ch98-1/High-Voltage-Power-Supply/README.md

# High Voltage Power Supply
High voltage power supply for main capacitor and igniter for PPT systems
