ch98-1/High-Voltage-Power-Supply/Enclosure/HVPS_Enclosure.FCStd

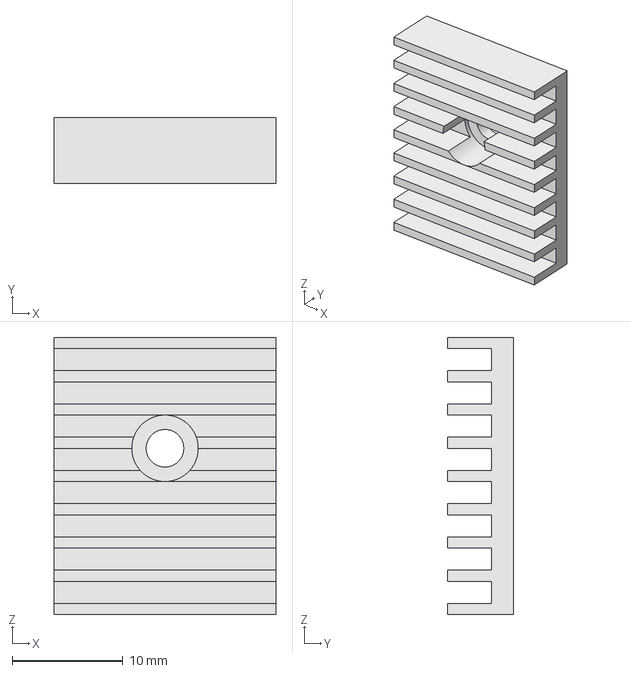
[picture p1: CAD file, 2021-12-09]
Enclosure/HVPS_Enclosure.FCStd
20.0 x 6.00 x 25.0 mm
