ch98-1/High-Voltage-Power-Supply/(list of files, cad)

Other CAD files:
Enclosure/HVPS_Enclosure-Heatsink.step
