ch98-1/High-Voltage-Power-Supply/High_Voltage_Power_Supply/High_Voltage_Power_Supply.pdf

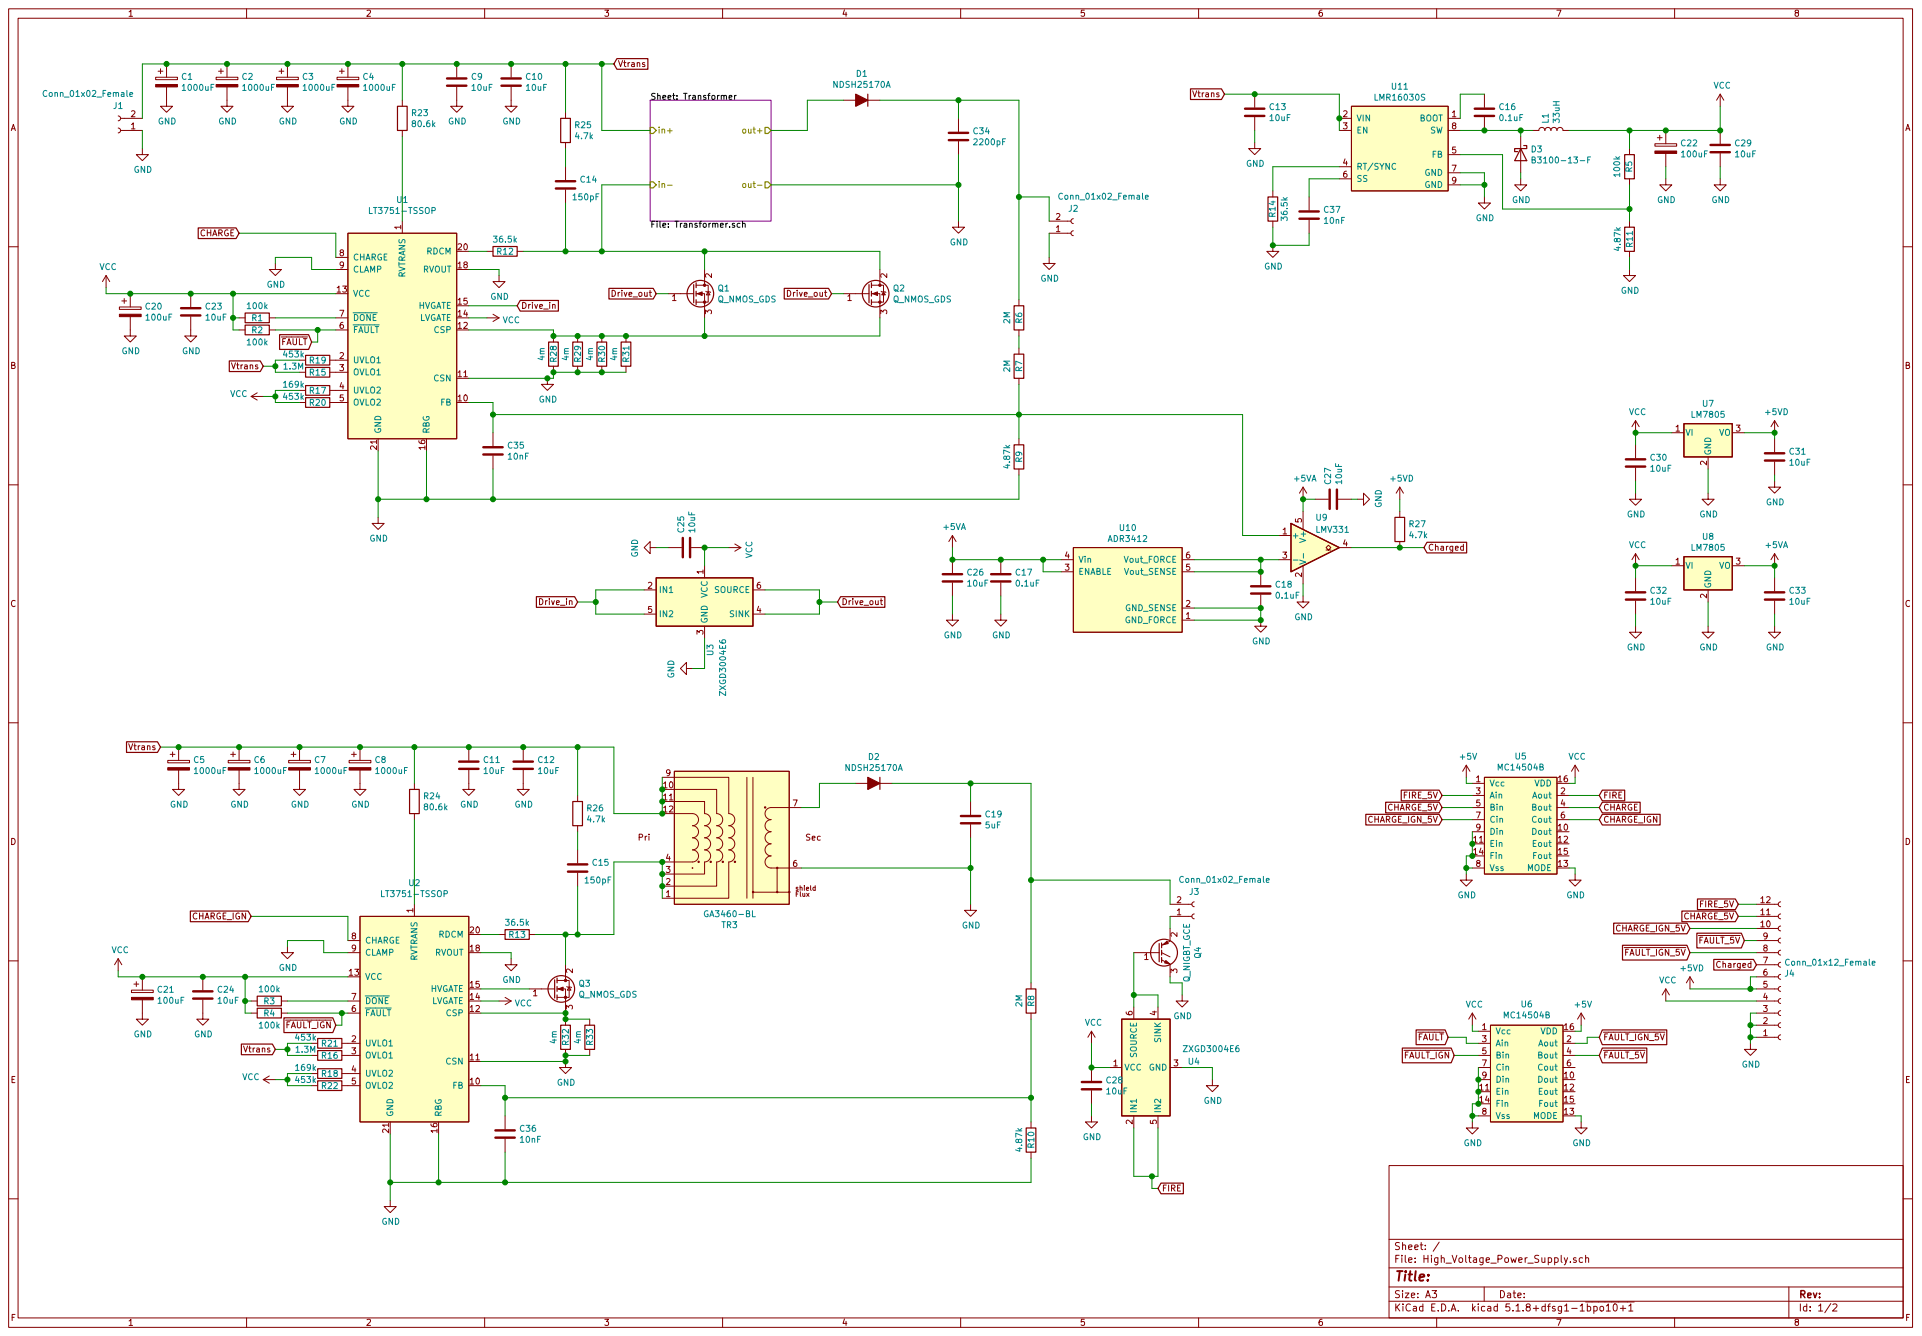
[picture p2: page 1]

Sheet: Transformer File: Transformer.sch

1 FB 10 CSN 11 CSP 12 VCC 13

11
12

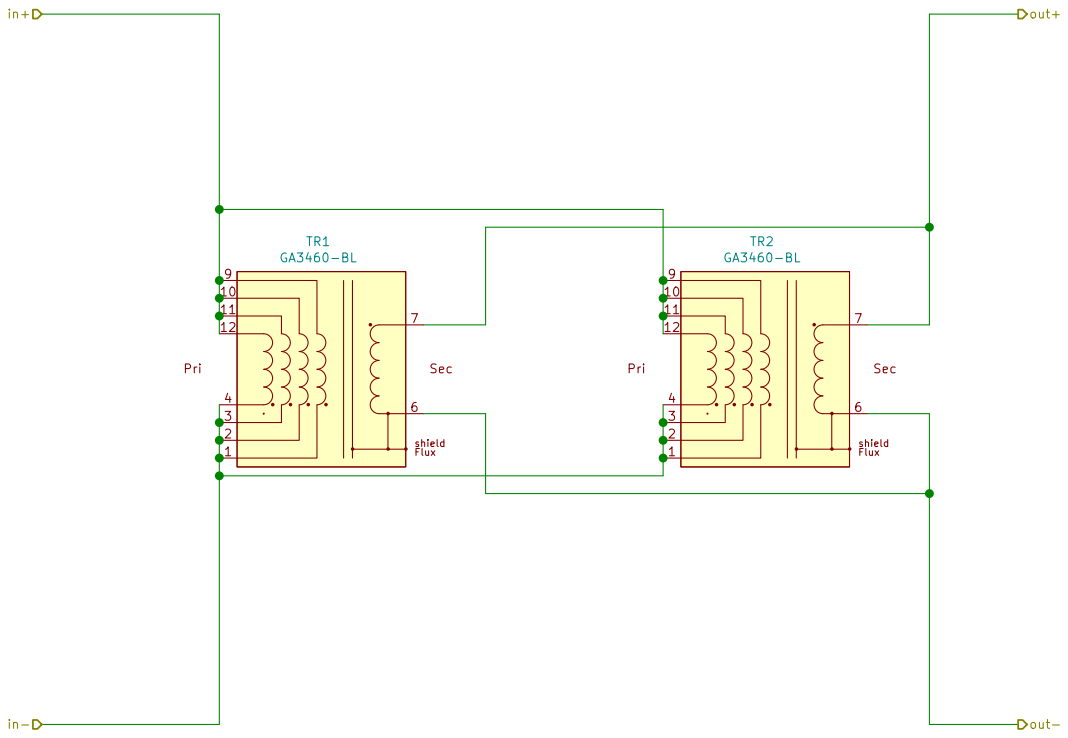
[picture p3: page 2]

Id: 2/2 Title: File: Transformer.sch Sheet: /Transformer/
