ch98-1/High-Voltage-Power-Supply/LTspice_Simulation/High_Voltage_Power_Supply_Simulation.asc

C1: cap; 2200pf
C2: cap; 80µf
C3: cap; 10nF
D1: diode; DNDSH25170A
L1: ind2; 1.125µH; Rser=2.815m
L2: ind2; 112.5µH; Rser=200m
M1: nmos; IXFK180N25T
M2: nmos; IPB200N25N3
R1: res; 80.6k
R2: res; 2Meg
R3: res; 2Meg
R4: res; 4.87k
R6: res; 1m
R7: res; 36.5k
R9: res; 100k
R10: res; 100k
R11: res; 1.3Meg
R12: res; 453k
R13: res; 453k
R14: res; 169k
U1: LT3751
V1: voltage; 12; Rser=0
V2: voltage; 48; Rser=0
V3: voltage; PULSE(0 12 1m 100n 100n 100)
Named nets: 0, VCC, vout, vtrans
K1 L1 L2 1
.tran 10ns 100m uic
.model IXFK180N25T NMOS(Vds=250 Ron=12.9m Qg=345n)
.model DNDSH25170A D (RS=0 BV=1700 IBV=50u )
