ch98-1/High-Voltage-Power-Supply/High_Voltage_Power_Supply/High_Voltage_Power_Supply.kicad_pcb

## KiCad design High_Voltage_Power_Supply/High_Voltage_Power_Supply.kicad_pcb (2021-12-11)

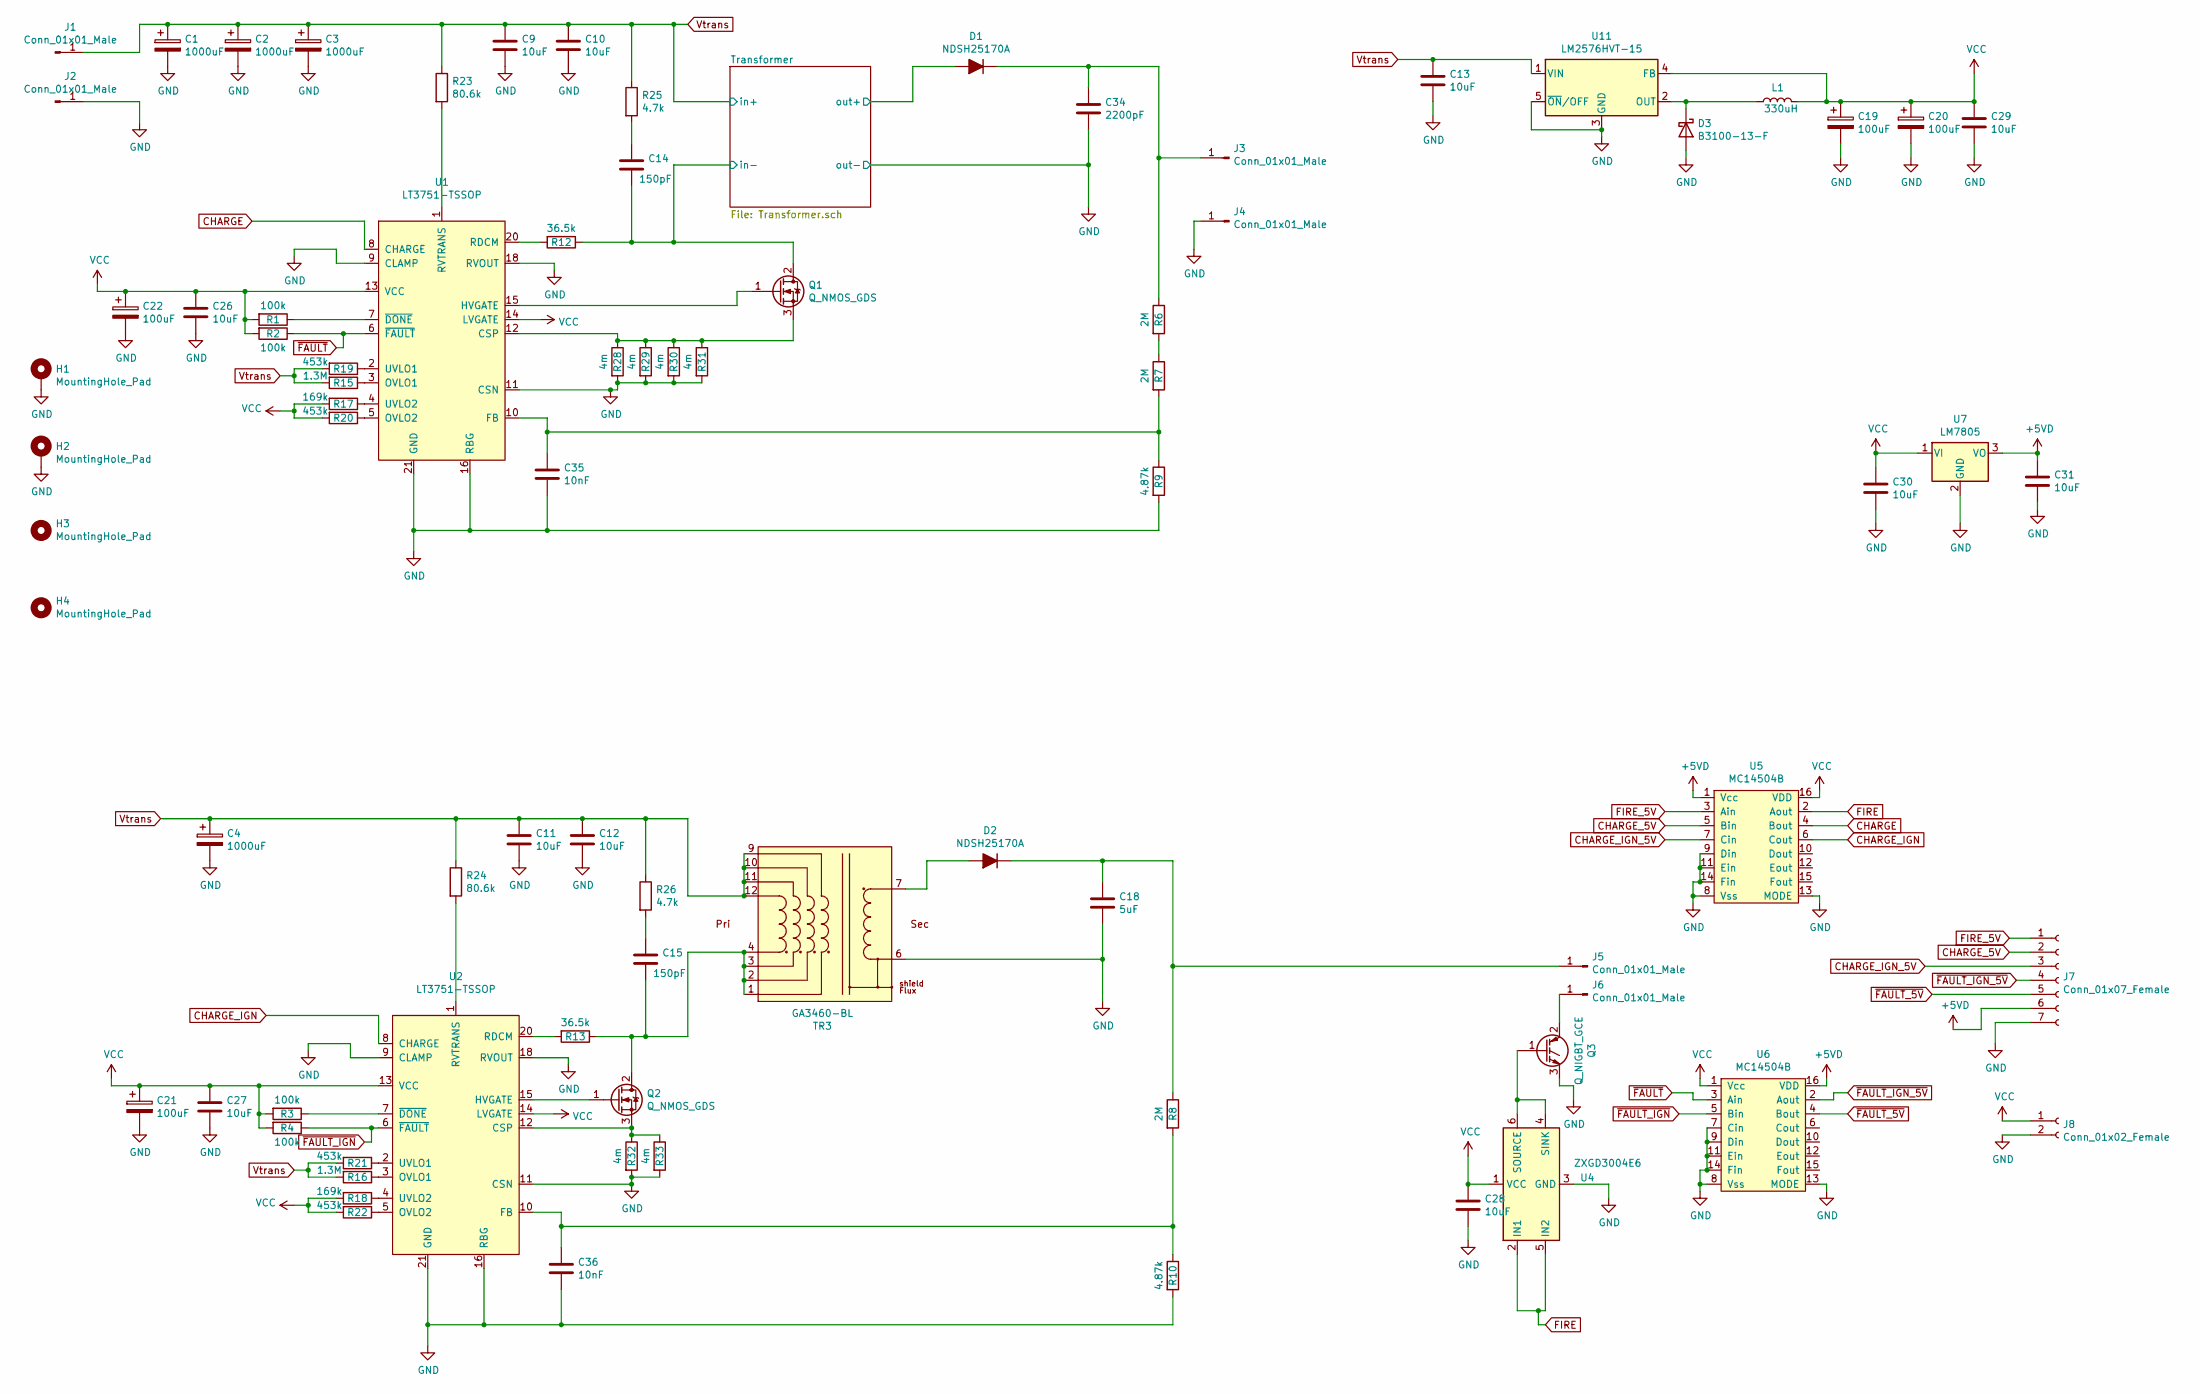
[picture p4: schematic High_Voltage_Power_Supply.sch]

Parts:
C1, C2, C3, C4: 1000uF; CP_Radial_D18.0mm_P7.50mm
C9, C10, C11, C12, C13: 10uF; C_1210_3225Metric; Voltage >100V
C14, C15: 150pF; C_1206_3216Metric
C18: 5uF; C_Rect_L31.5mm_W20.0mm_P27.50mm_MKS4; Voltage >600V
C19, C20, C21, C22: 100uF; CP_Radial_D8.0mm_P5.00mm
C26, C27, C28, C29, C30, C31: 10uF; C_1206_3216Metric; Voltage >50V
C34: 2200pF; C_1812_4532Metric; Voltage >1200V
C35, C36: 10nF; C_0603_1608Metric
D1, D2: NDSH25170A; TO-247-2_Vertical
D3: B3100-13-F; D_SMC
H1, H2: MountingHole_Pad; MountingHole_3.2mm_M3_Pad_Via
H3, H4: MountingHole_Pad; MountingHole_3.2mm_M3
J1, J2, J3, J4, J5, J6: Conn_01x01_Male; Banana_Jack_1Pin
J7: Conn_01x07_Female; PinHeader_1x07_P2.54mm_Vertical
J8: Conn_01x02_Female; PinHeader_1x02_P2.54mm_Vertical
L1: 330uH; 60B334C
Q1, Q2: Q_NMOS_GDS; TO-264-3_Vertical; Voltage 200V
Q3: Q_NIGBT_GCE; TO-247-3_Vertical; Voltage >600V
R1, R2, R3, R4: 100k; R_0603_1608Metric
R6, R7, R8: 2M; R_1206_3216Metric
R9, R10: 4.87k; R_1206_3216Metric
R12, R13: 36.5k; R_0603_1608Metric
R15, R16: 1.3M; R_0805_2012Metric
R17, R18: 169k; R_0805_2012Metric
R19, R20, R21, R22: 453k; R_0805_2012Metric
R23, R24: 80.6k; R_0603_1608Metric
R25, R26: 4.7k; R_1206_3216Metric
R28, R29, R30, R31, R32, R33: 4m; R_2512_6332Metric
TR3: GA3460-BL; Transformer_Coilcraft_GA3460-BL
U1, U2: LT3751-TSSOP; HTSSOP-20-1EP_4.4x6.5mm_P0.65mm_EP3.4x6.5mm_ThermalVias
U4: ZXGD3004E6; SOT-23-6
U5, U6: MC14504B; SOIC-16_3.9x9.9mm_P1.27mm
U7: LM7805; SOT-223-3_TabPin2
U11: LM2576HVT-15; TO-220-5_Vertical

Connections:
+5VD: C31.1, J7.6, U5.1 (Vcc), U6.16 (VDD), U7.3 (VO)
/Transformer/in-: C14.2, Q1.2 (D), R12.1; also elsewhere on the board
/Transformer/out+: D1.2 (A); also elsewhere on the board
CHARGE: U1.8 (CHARGE), U5.4 (Bout)
CHARGE_5V: J7.2, U5.5 (Bin)
CHARGE_IGN: U2.8 (CHARGE), U5.6 (Cout)
CHARGE_IGN_5V: J7.3, U5.7 (Cin)
FIRE: U4.2 (IN1), U4.5 (IN2), U5.2 (Aout)
FIRE_5V: J7.1, U5.3 (Ain)
GND: C1.2, C2.2, C3.2, C4.2, C9.2, C10.2, C11.2, C12.2, C13.2, C18.2, C19.2, C20.2, C21.2, C22.2, C26.2, C27.2, C28.2, C29.2, C30.2, C31.2, C34.2, C35.2, C36.2, D3.2 (A), H1.1, H2.1, J2.1, J4.1, J7.7, J8.2, Q3.3 (E), R9.2, R10.2, R28.2, R29.2, R30.2, R31.2, R32.2, R33.2, TR3.6, U1.9 (CLAMP), U1.11 (CSN), U1.16 (RBG), U1.18 (RVOUT), U1.21 (GND), U2.9 (CLAMP), U2.11 (CSN), U2.16 (RBG), U2.18 (RVOUT), U2.21 (GND), U4.3 (GND), U5.8 (Vss), U5.9 (Din), U5.11 (Ein), U5.13 (MODE), U5.14 (Fin), U6.7 (Cin), U6.8 (Vss), U6.9 (Din), U6.11 (Ein), U6.13 (MODE), U6.14 (Fin), U7.2 (GND), U11.3 (GND), U11.5 (~ON~/OFF); also elsewhere on the board
unnamed: C14.1, R25.2
unnamed: C15.1, R26.2
unnamed: C15.2, Q2.2 (D), R13.1, TR3.1, TR3.2, TR3.3, TR3.4
unnamed: C18.1, D2.1 (K), J5.1, R8.1
unnamed: C34.1, D1.1 (K), J3.1, R6.1
unnamed: C35.1, R7.2, R9.1, U1.10 (FB)
unnamed: C36.1, R8.2, R10.1, U2.10 (FB)
unnamed: D2.2 (A), TR3.7
unnamed: D3.1 (K), L1.1, U11.2 (OUT)
unnamed: J6.1, Q3.2 (C)
unnamed: Q1.1 (G), U1.15 (HVGATE)
unnamed: Q1.3 (S), R28.1, R29.1, R30.1, R31.1, U1.12 (CSP)
unnamed: Q2.1 (G), U2.15 (HVGATE)
unnamed: Q2.3 (S), R32.1, R33.1, U2.12 (CSP)
unnamed: Q3.1 (G), U4.4 (SINK), U4.6 (SOURCE)
unnamed: R1.1, U1.7 (~DONE~)
unnamed: R3.1, U2.7 (~DONE~)
unnamed: R6.2, R7.1
unnamed: R12.2, U1.20 (RDCM)
unnamed: R13.2, U2.20 (RDCM)
unnamed: R15.1, U1.3 (OVLO1)
unnamed: R16.1, U2.3 (OVLO1)
unnamed: R17.1, U1.4 (UVLO2)
unnamed: R18.1, U2.4 (UVLO2)
unnamed: R19.1, U1.2 (UVLO1)
unnamed: R20.1, U1.5 (OVLO2)
unnamed: R21.1, U2.2 (UVLO1)
unnamed: R22.1, U2.5 (OVLO2)
unnamed: R23.2, U1.1 (RVTRANS)
unnamed: R24.2, U2.1 (RVTRANS)
VCC: C19.1, C20.1, C21.1, C22.1, C26.1, C27.1, C28.1, C29.1, C30.1, J8.1, L1.2, R1.2, R2.2, R3.2, R4.2, R17.2, R18.2, R20.2, R22.2, U1.13 (VCC), U1.14 (LVGATE), U2.13 (VCC), U2.14 (LVGATE), U4.1 (VCC), U5.16 (VDD), U6.1 (Vcc), U7.1 (VI), U11.4 (FB)
Vtrans: C1.1, C2.1, C3.1, C4.1, C9.1, C10.1, C11.1, C12.1, C13.1, J1.1, R15.2, R16.2, R19.2, R21.2, R23.1, R24.1, R25.1, R26.1, TR3.9, TR3.10, TR3.11, TR3.12, U11.1 (VIN); also elsewhere on the board
~FAULT_5V~: J7.5, U6.4 (Bout)
~FAULT_IGN_5V~: J7.4, U6.2 (Aout)
~FAULT_IGN~: R4.1, U2.6 (~FAULT~), U6.5 (Bin)
~FAULT~: R2.1, U1.6 (~FAULT~), U6.3 (Ain)

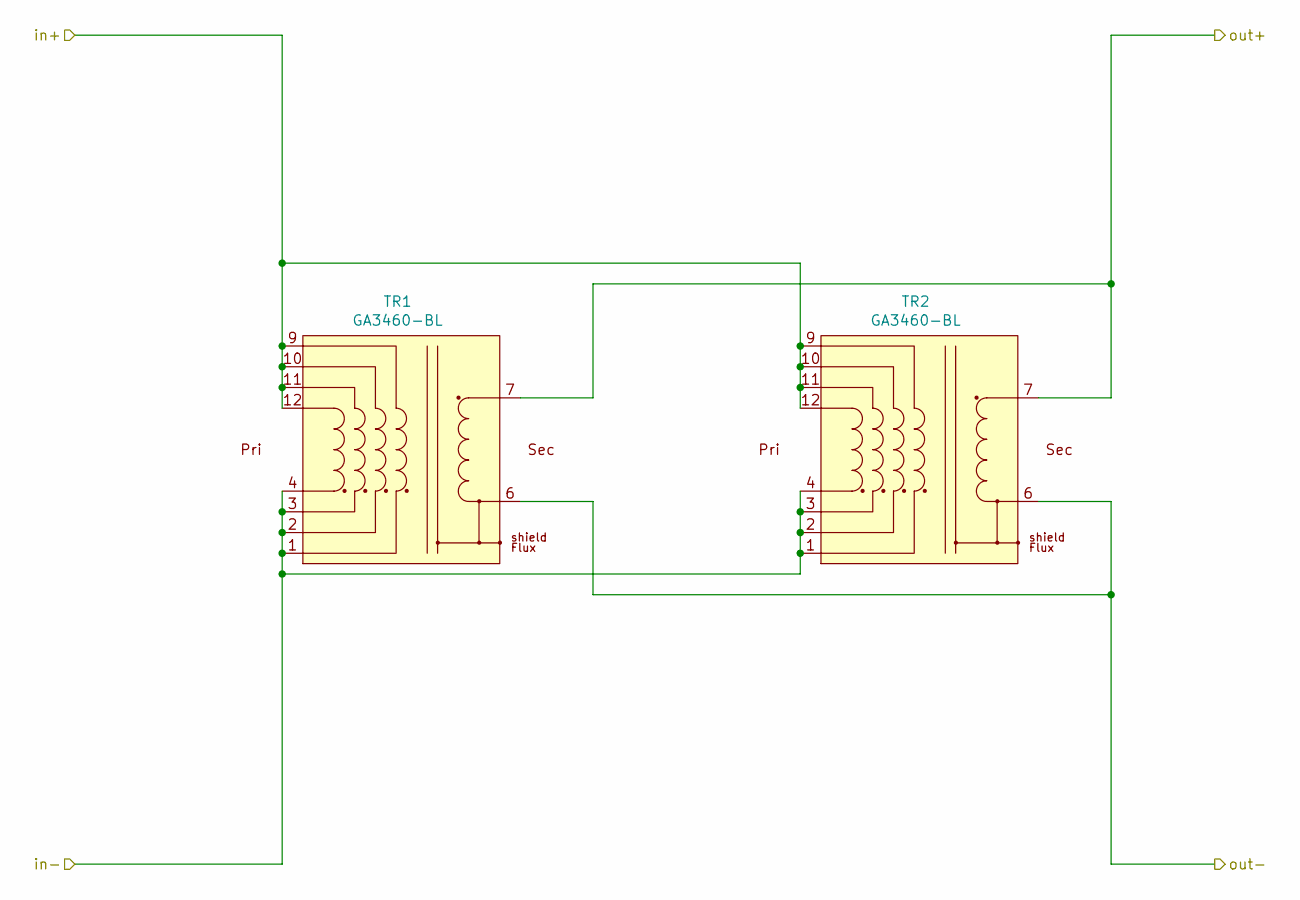
[picture p5: schematic Transformer.sch]

Parts:
TR1, TR2: GA3460-BL; Transformer_Coilcraft_GA3460-BL

Connections:
/Transformer/in-: TR1.1, TR1.2, TR1.3, TR1.4, TR2.1, TR2.2, TR2.3, TR2.4; also elsewhere on the board
/Transformer/out+: TR1.7, TR2.7; also elsewhere on the board
GND: TR1.6, TR2.6; also elsewhere on the board
Vtrans: TR1.9, TR1.10, TR1.11, TR1.12, TR2.9, TR2.10, TR2.11, TR2.12; also elsewhere on the board

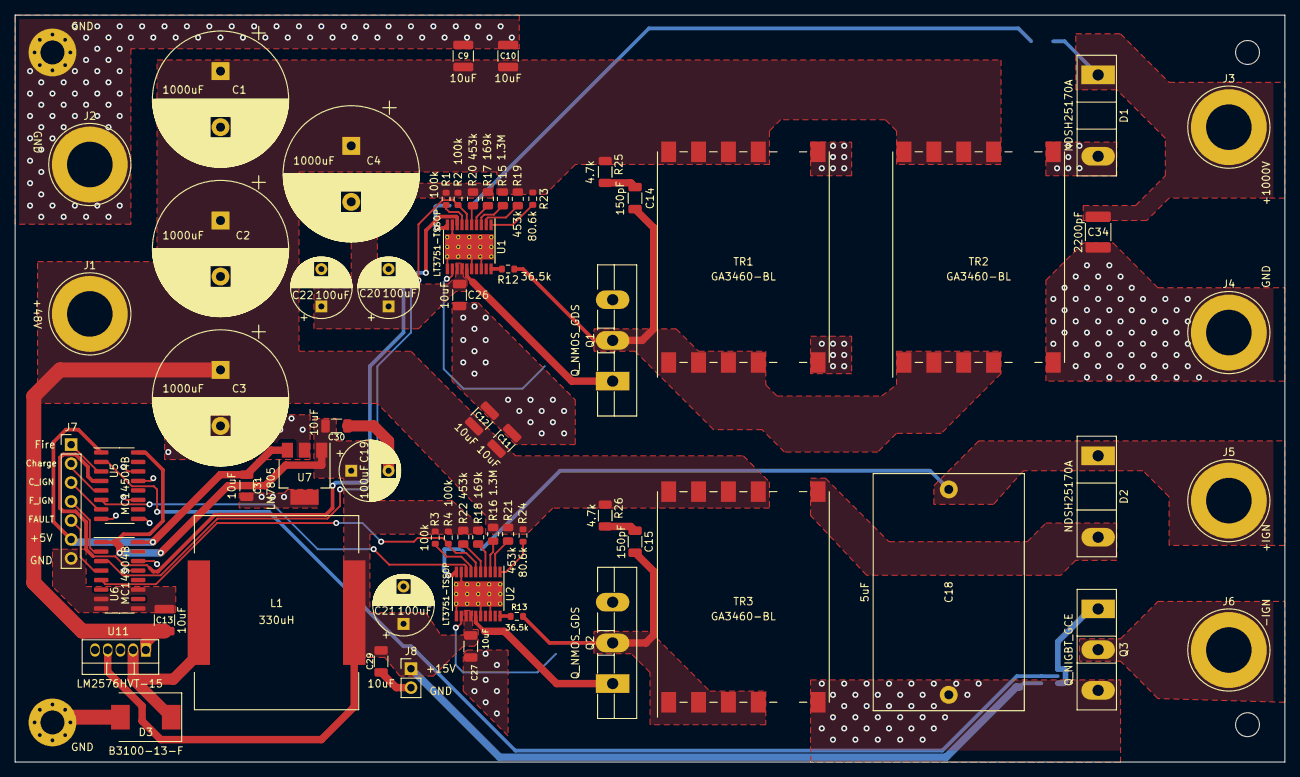
[picture p6: board High_Voltage_Power_Supply.kicad_pcb from above]

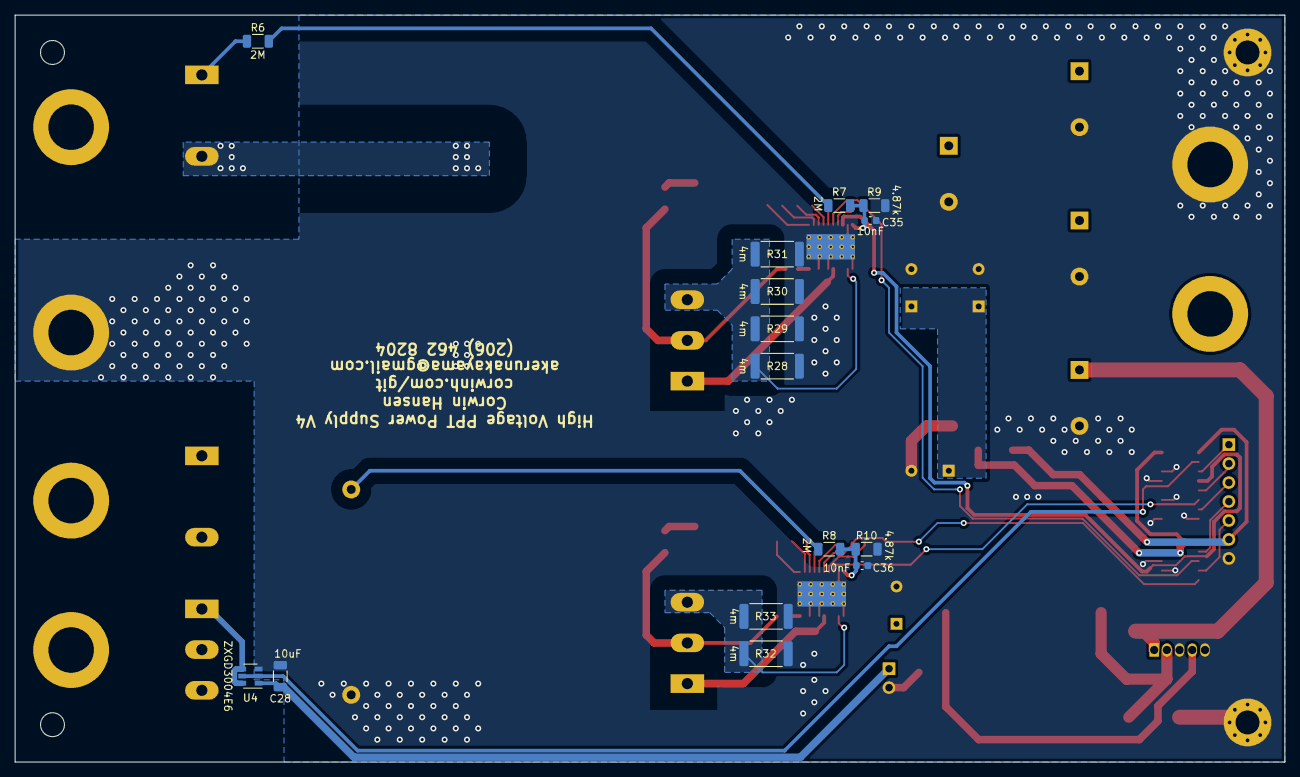
[picture p7: board High_Voltage_Power_Supply.kicad_pcb from below]

Board: 2 copper layers, 170.0 x 100.0 mm, 83 parts (15 on the bottom side), 46 nets.
