ch98-1/High-Voltage-Power-Supply/(commit log)

2018-08-30 Added project files and license
    [High Voltage Power Supply.kicad_pcb, High Voltage Power Supply.sch]
2018-08-31 Finished basic power supply schematic
    [High Voltage Power Supply.sch, High_Voltage_Power_Supply.kicad_pcb, High_Voltage_Power_Supply.sch]
2018-08-31 Centered schematic
    [High_Voltage_Power_Supply.sch]
2019-02-21 Added schimatic PDF
    [High_Voltage_Power_Supply.sch]
2020-08-05 More basic component updates
    [Transformer.sch]
2020-08-08 Finalised the schematic and BOM
    [Bom_Digikey.csv, High_Voltage_Power_Supply.sch, Transformer.sch]
2020-08-08 Started on the PCB
    [High_Voltage_Power_Supply.sch]
2020-08-14 Finished most of the PCB layout
    [High_Voltage_Power_Supply.kicad_pcb, High_Voltage_Power_Supply.sch, Transformer.sch]
2020-08-14 Added Done and Fault outputs
    [High_Voltage_Power_Supply.kicad_pcb, High_Voltage_Power_Supply.sch]
2020-08-15 Updated text location
    [High_Voltage_Power_Supply.kicad_pcb]
2020-08-19 Started on LTspice simulation file for the circuit
2020-08-21 minor pcb update
    [High_Voltage_Power_Supply.kicad_pcb]
2020-08-21 updated pcb
2020-08-26 Added some notes for it
    [High_Voltage_Power_Supply.sch]
2020-08-26 Fixed the order qualtity mistake
    [Bom_Digikey.csv]
2020-09-05 modified PCB to have all the silkscreen text visible
    [High_Voltage_Power_Supply.kicad_pcb]
2020-09-05 Removed a via in the wrong position
    [High_Voltage_Power_Supply.kicad_pcb]
2020-10-01 Updated schematic to run on regulation mode only
    [Bom_Digikey.csv, High_Voltage_Power_Supply.kicad_pcb, High_Voltage_Power_Supply.sch, Transformer.sch]
2020-10-01 Started PCB layout for new version of the board
    [High_Voltage_Power_Supply.kicad_pcb]
2020-10-02 removed unnecessory item from bom
    [Bom_Digikey.csv]
2020-10-03 did more pcb layout
    [High_Voltage_Power_Supply.kicad_pcb]
2020-10-03 filled unfilled zones
    [High_Voltage_Power_Supply.kicad_pcb]
2020-10-15 Started design of the ignitor circuit
    [High_Voltage_Power_Supply.kicad_pcb, High_Voltage_Power_Supply.sch, Transformer.sch]
2020-10-18 schematic update
    [High_Voltage_Power_Supply.sch]
2020-10-28 Finished the v2 of the schematic
    [High_Voltage_Power_Supply.sch, Transformer.sch]
2020-10-28 Updated BOM
    [Bom_Digikey.csv, High_Voltage_Power_Supply.sch]
2020-10-29 pcb fully layed out
    [Bom_Digikey.csv, High_Voltage_Power_Supply.kicad_pcb, High_Voltage_Power_Supply.sch]
2020-10-29 Layout update for minor labling issues
    [High_Voltage_Power_Supply.kicad_pcb]
2020-10-29 more layout update
    [High_Voltage_Power_Supply.kicad_pcb]
2020-10-29 added labels on pins
    [High_Voltage_Power_Supply.kicad_pcb]
2020-11-12 made small adjustments to pcb to clean it up a bit
    [High_Voltage_Power_Supply.kicad_pcb]
2020-11-12 more change with vias
    [High_Voltage_Power_Supply.kicad_pcb]
2020-11-14 updated text to be right way around
    [High_Voltage_Power_Supply.kicad_pcb]
2020-11-17 pin labling error fixed and arduino project for testing added
    [High_Voltage_Power_Supply.kicad_pcb]
2021-04-23 Created V3 of the schematic
    [High_Voltage_Power_Supply.kicad_pcb, High_Voltage_Power_Supply.sch]
2021-04-27 schematic update with mounting holes
    [High_Voltage_Power_Supply.kicad_pcb, High_Voltage_Power_Supply.sch]
2021-05-25 added new components and replaced out of stock ones in BOM
    [Bom_Digikey.csv, High_Voltage_Power_Supply.kicad_pcb, High_Voltage_Power_Supply.sch]
2021-05-27 Edited schematic to use new buck converter chip.
    [Bom_Digikey.csv, High_Voltage_Power_Supply.kicad_pcb, High_Voltage_Power_Supply.sch]
2021-06-15 Rough component placements to allow heat sinks to be installed
    [High_Voltage_Power_Supply.kicad_pcb, High_Voltage_Power_Supply.sch]
2021-06-19 routed most of the components on pcb
    [High_Voltage_Power_Supply.kicad_pcb, High_Voltage_Power_Supply.sch]
2021-06-19 more work on pcb routuing
    [High_Voltage_Power_Supply.kicad_pcb]
2021-06-22 traces fully laid out
    [High_Voltage_Power_Supply.kicad_pcb]
2021-06-22 labeled components
    [High_Voltage_Power_Supply.kicad_pcb]
2021-06-22 updated silkscreen labeling
    [High_Voltage_Power_Supply.kicad_pcb]
2021-06-25 minor update to labeling for pcb
    [High_Voltage_Power_Supply.kicad_pcb]
2021-06-26 Minor layout change
    [High_Voltage_Power_Supply.kicad_pcb]
2021-06-26 added more labeling
    [High_Voltage_Power_Supply.kicad_pcb]
2021-06-26 Mirrored the text on the back
    [High_Voltage_Power_Supply.kicad_pcb]
2021-06-26 updated pcb view
    [High_Voltage_Power_Supply.kicad_pcb]
2021-07-20 minor fix on vias not connected to anything
    [High_Voltage_Power_Supply.kicad_pcb]
2021-07-20 Minor bom and text change
    [Bom_Digikey.csv, High_Voltage_Power_Supply.kicad_pcb]
2021-07-20 More bom update
    [Bom_Digikey.csv]
2021-07-28 Updated component list and schematic for v4
    [Bom_Digikey.csv, High_Voltage_Power_Supply.kicad_pcb, High_Voltage_Power_Supply.sch]
2021-07-28 updated label text
    [High_Voltage_Power_Supply.kicad_pcb]
2021-09-02 Component updates for new version
    [Bom_Digikey.csv, High_Voltage_Power_Supply.kicad_pcb, High_Voltage_Power_Supply.sch]
2021-09-04 updated components to match new requirements from experiments
    [Bom_Digikey.csv, High_Voltage_Power_Supply.kicad_pcb, High_Voltage_Power_Supply.sch]
2021-12-09 finished pcb v4 layout. Added cad for heatsink.
    [HVPS_Enclosure-Heatsink.step, HVPS_Enclosure.FCStd, High_Voltage_Power_Supply.kicad_pcb, High_Voltage_Power_Supply.sch]
2021-12-09 cleaned up heat sink cad
    [HVPS_Enclosure.FCStd]
2021-12-10 minor layout update
    [High_Voltage_Power_Supply.kicad_pcb]
2021-12-11 minor updates on vias
    [High_Voltage_Power_Supply.kicad_pcb]
2021-12-11 fixed some issues
    [High_Voltage_Power_Supply.kicad_pcb]
